lancekindle/TOMY2ThomasTrainTrackAdapter/brown tracks.png

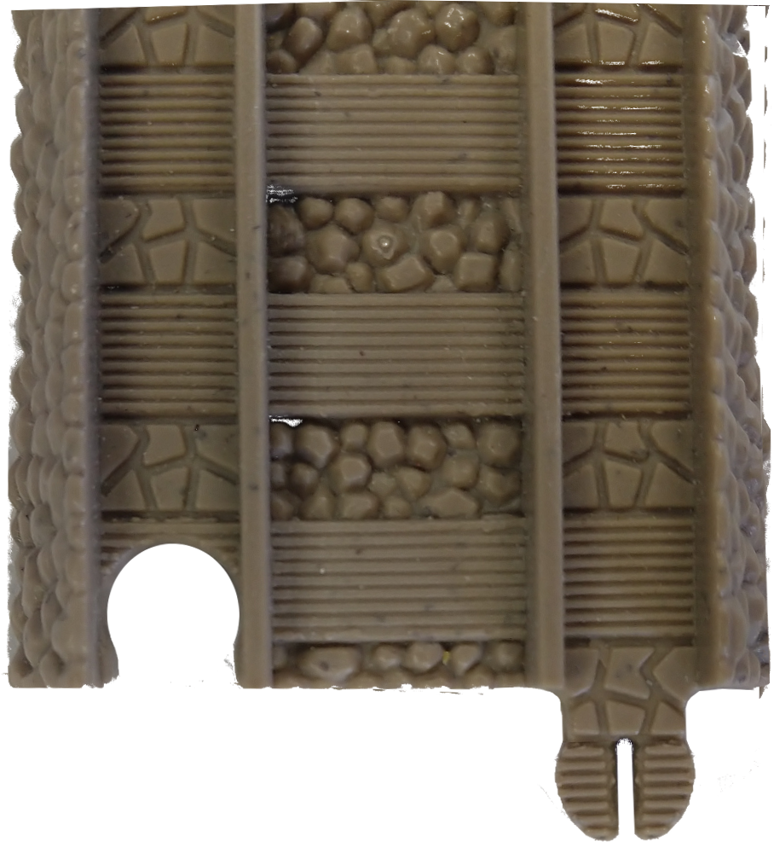
brown tracks.png
