lancekindle/TOMY2ThomasTrainTrackAdapter/blue_tracks.png

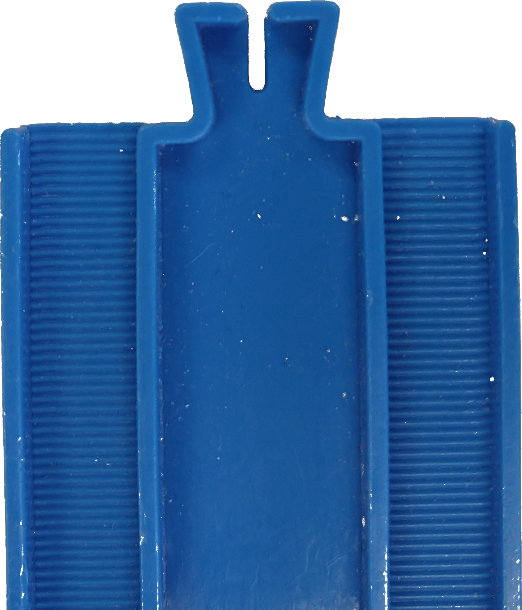
blue_tracks.png
