lancekindle/TOMY2ThomasTrainTrackAdapter/3D_train_tracks_adapter.png

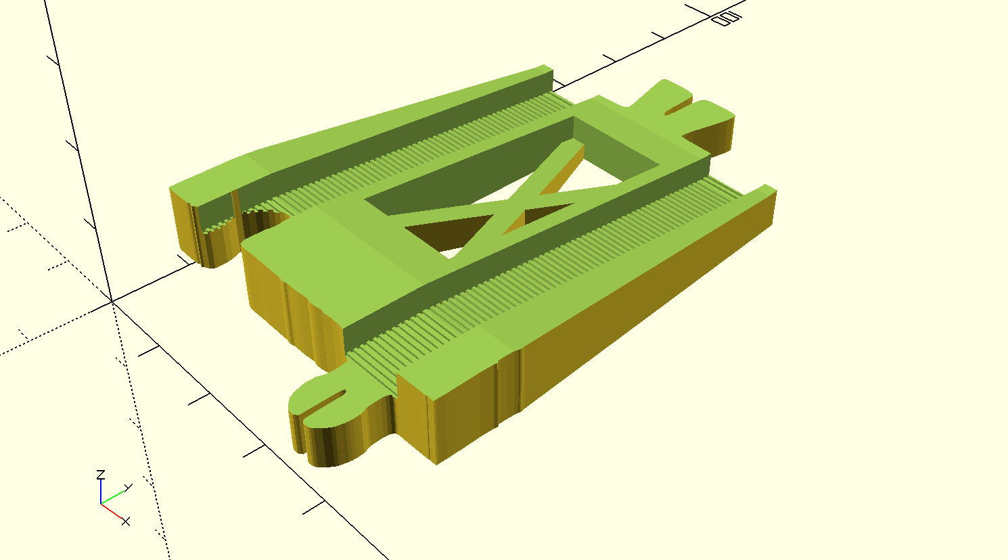
3D_train_tracks_adapter.png
