lancekindle/TOMY2ThomasTrainTrackAdapter/3D_train_tracks_adapter.stl

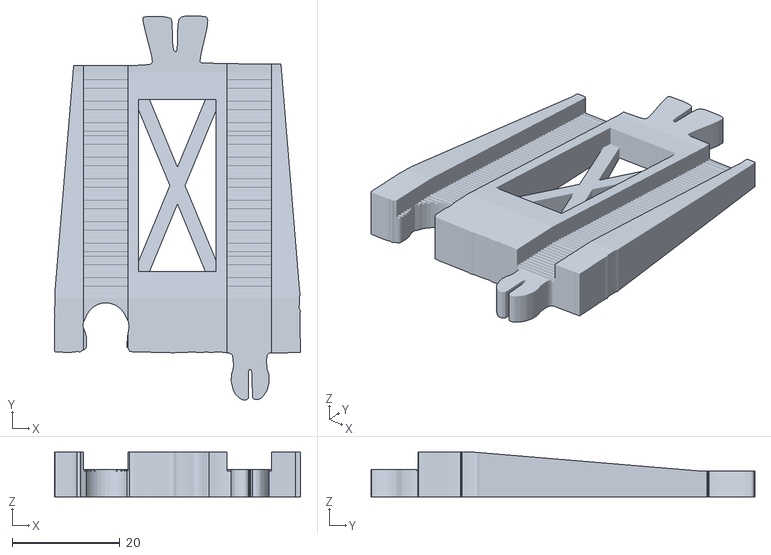
[picture p4: CAD file, 2018-09-11]
3D_train_tracks_adapter.stl
45.7 x 71.4 x 8.35
