lancekindle/TOMY2ThomasTrainTrackAdapter/joined_train_tracks.dxf

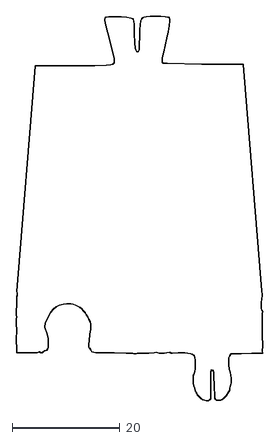
[picture p5: CAD file, 2018-08-22]
joined_train_tracks.dxf
45.7 x 71.4
