lancekindle/TOMY2ThomasTrainTrackAdapter/(commit log)

2018-08-21 initial commit - 3D model tight fit
    [3D_train_tracks_adapter.scad, joined_train_tracks.dxf, printable_train_tracks_adapter.stl]
2018-08-22 increase connection margins
    male connectors shrunk; female connections widened slightly. I only
    changed the .dxf file because the laser cut file .svg is already fine
    [3D_train_tracks_adapter.scad, joined_train_tracks.dxf]
2018-08-22 revise blue track height
    [3D_train_tracks_adapter.scad]
2018-08-26 add height margin to cutouts
    when quick-rendered, the module looks aweful because everything is cut to
    exact dimensions, so corners and edges are "hair-thin" in quick renders.
    Only full renders will remove those infinitely small edges. So I add some
    margin to cuts and change the base-cut from a copy of the outline to a
    large cube. Also causes faster renders
    [3D_train_tracks_adapter.scad]
2018-09-11 add traction strips
    Cut into the base track small "notches" that the train wheels can grab
    [3D_train_tracks_adapter.scad, 3D_train_tracks_adapter.stl, printable_train_tracks_adapter.stl]
2018-09-11 improve readability, add EDIT comments
    commented "EDIT" where the user is most likely to need to edit the model
    to achieve a proper 3D print, depending on nozzle size and acrylic base
    height (if any)
    [3D_train_tracks_adapter.scad]
